domlaps/ultrasonic_radar/journey/README.md

# Build journey

How the radar went from a parts list to a working build, in order — including the mistakes.
The finished design (firmware, schematic, calculations) is in [`final/`](../final/).

| File | What's in it |
|---|---|
| [engineering-log.md](engineering-log.md) | Day-by-day record: decisions, measurements, what went wrong |
| [problems-and-fixes.md](problems-and-fixes.md) | Every fault I hit: what I saw → cause → how I found it → fix |
| [photos](photos/) | Photos in build order |

## Timeline in photos

### 1. First wiring attempt
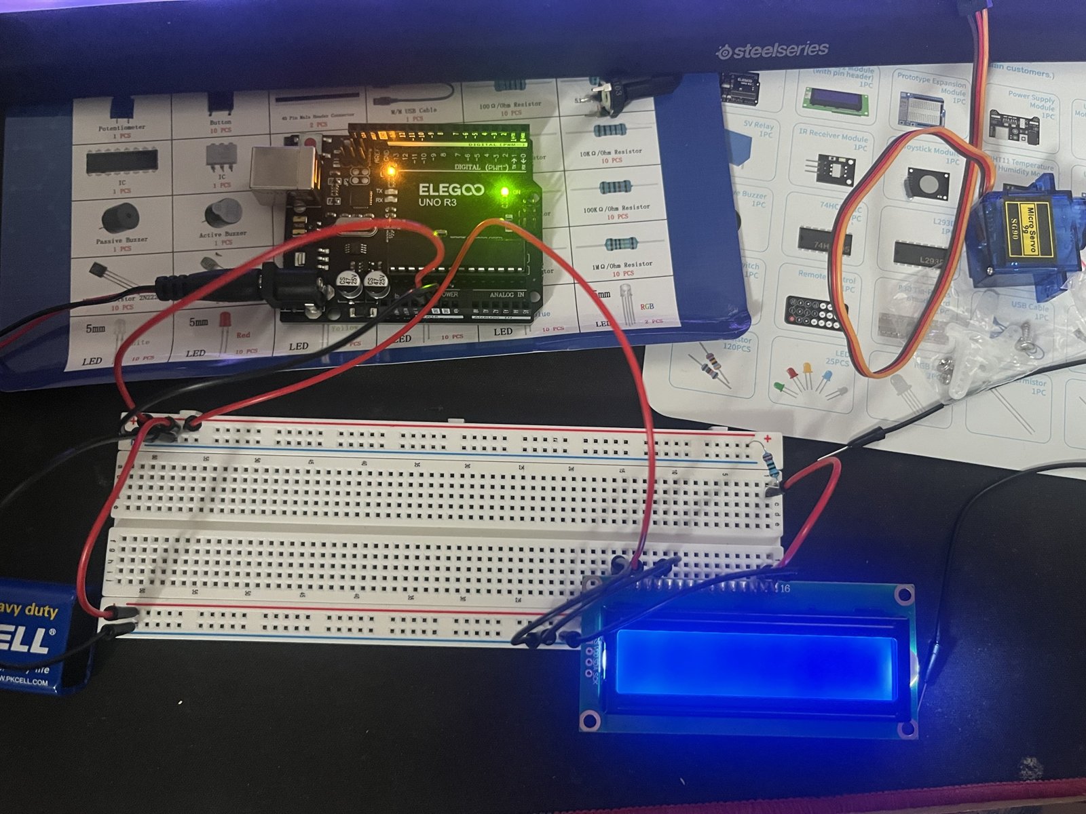
[picture p3: journey/photos/2026-10-24_01-first-wiring-attempt.jpg]
First wiring attempt


Getting the Uno, breadboard and LCD laid out for the first time, with the backlight powered.

### 2. Power rails and LCD backlight 
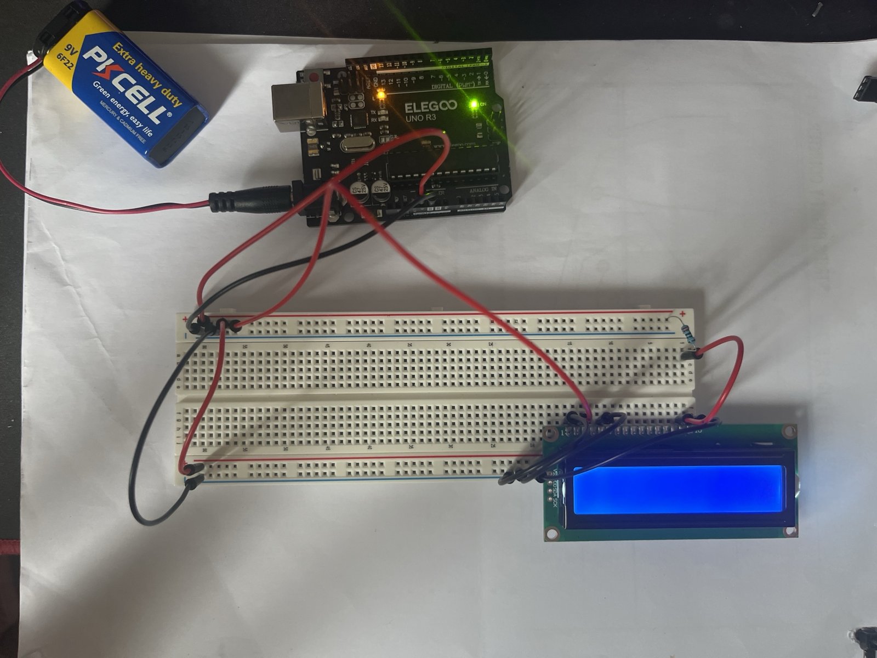
[picture p4: journey/photos/2026-10-24_02-power-rails-and-lcd-backlight.jpg]
Power rails and LCD backlight


9 V battery into the Uno's barrel jack; the breadboard rails are fed from the Uno's 5V and
GND pins, so the LCD only ever sees 5 V. Before this, one + rail on my first breadboard was
damaged and I swapped boards — see [problems-and-fixes.md](problems-and-fixes.md).

### 3. Contrast pot fitted
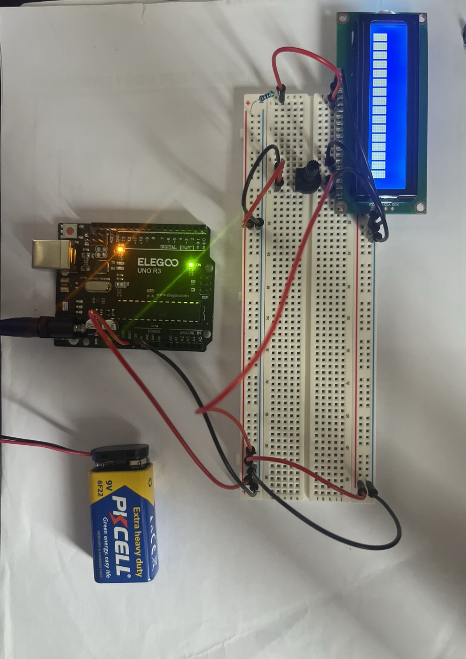
[picture p5: journey/photos/2026-10-24_03-contrast-pot-fitted.jpg]
Contrast pot fitted


With the 10 kΩ pot on V0 and no code running, the top line shows solid blocks: the LCD is
powered and the contrast works, but it hasn't been initialised yet.

### 4. Measuring the contrast voltage 
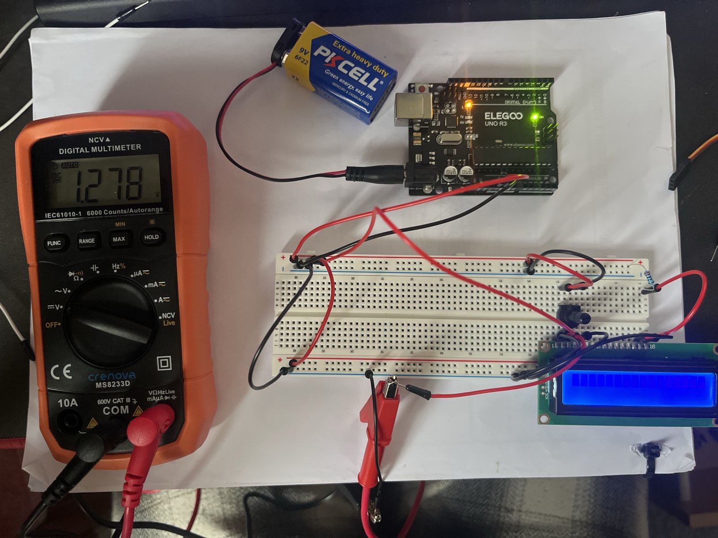
[picture p6: journey/photos/2026-10-24_04-lcd-v0-measurement.jpg]
Measuring V0


V0 = **1.278 V**, against the datasheet's ≈ 1.2 V (VDD − V0 = 3.8 V). That's about 2 % from
the recommended setting.

### 5. LCD wiring test passed 
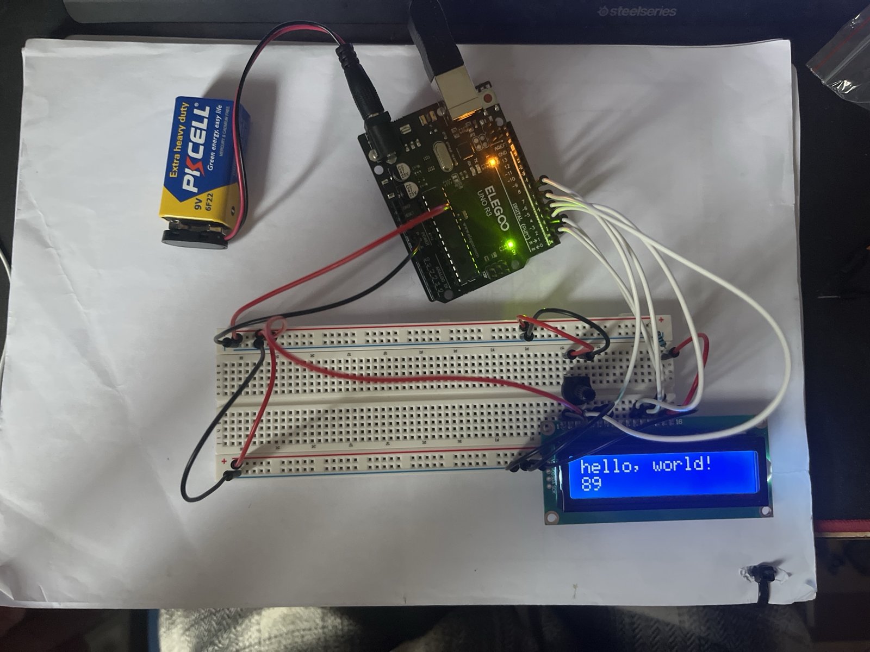
[picture p7: journey/photos/2026-10-24_05-lcd-helloworld-test.jpg]
LCD HelloWorld test


Six signal wires to the Uno and the IDE's HelloWorld example uploaded: text on line 1, a
seconds counter on line 2. The blocks from step 3 disappear once `lcd.begin()` runs.

### 6. LEDs and buzzer wired
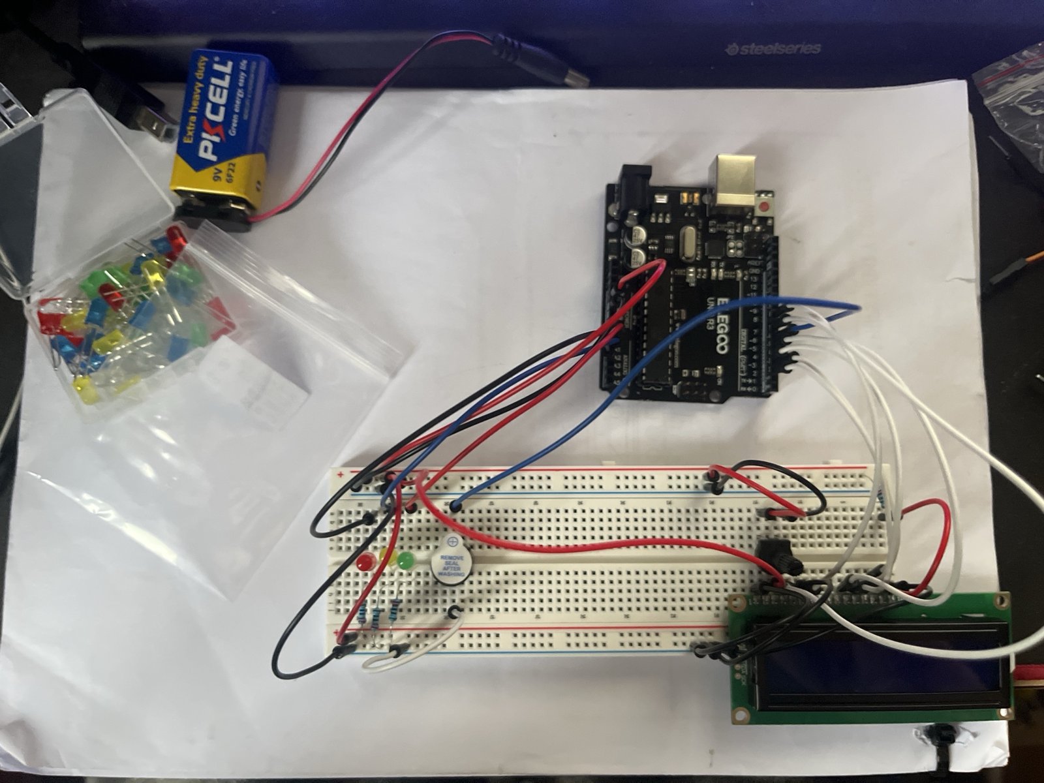
[picture p8: journey/photos/2026-10-24_06-leds-and-buzzer-wired.jpg]
LEDs and buzzer wired


Red, yellow and green LEDs, each with a 220 Ω resistor, plus the active buzzer, added to the
breadboard and wired to the Uno. Taken before powering up (the LCD is dark because the board
is unplugged), so this stage isn't tested yet.

### 7. Full circuit wired
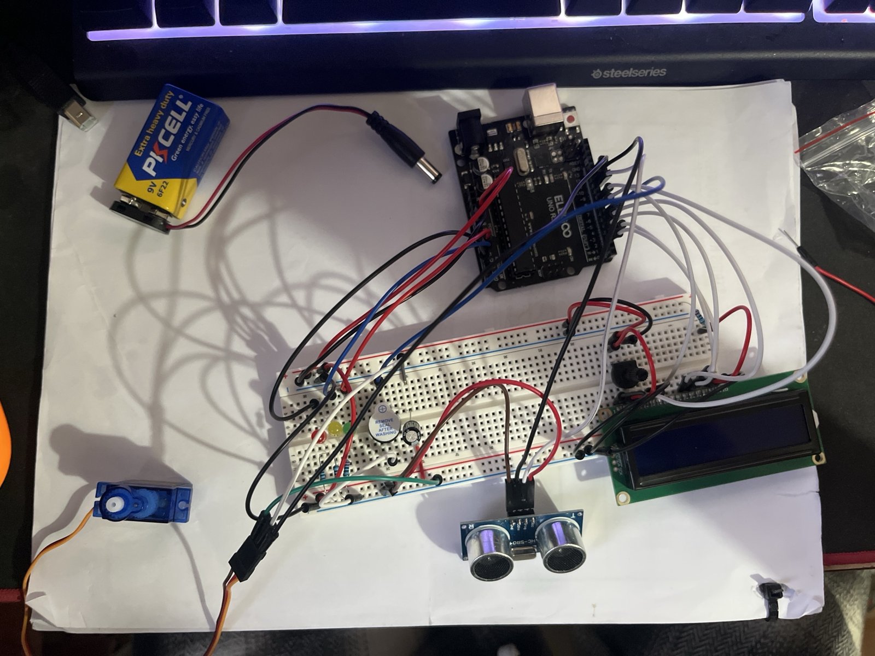
[picture p9: journey/photos/2026-10-24_07-full-circuit-wired.jpg]
Full circuit wired


Every part is now on the board: the HC-SR04 sensor and SG90 servo on jumper leads, and the
100 µF capacitor for the servo supply, alongside the LCD, LEDs and buzzer. Taken unpowered,
before the first full test. The sensor isn't mounted on the servo horn yet.

### 8. Working radar 
The finished build

First full run worked. The sensor is taped to the servo horn, and the LCD reads
"Angle: 90°, Dist: 20 cm" — right on the yellow/red boundary, with the yellow LED lit.

The radar reacting to my hand
