domlaps/ultrasonic_radar/final/hardware/images/schematic.png

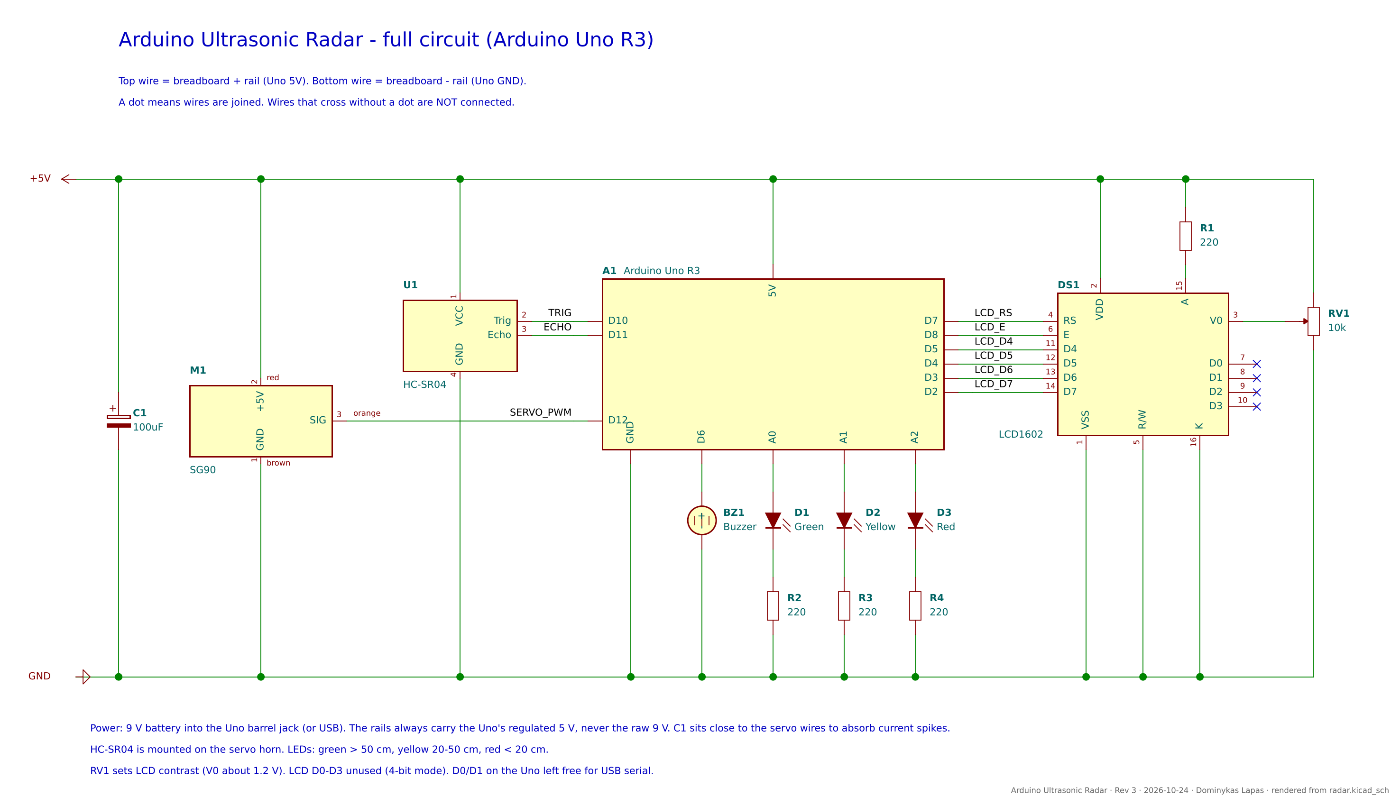
final/hardware/images/schematic.png
