domlaps/ultrasonic_radar/final/hardware/kicad/radar.kicad_sch

## KiCad design final/hardware/kicad/radar.kicad_sch (2026-10-24)

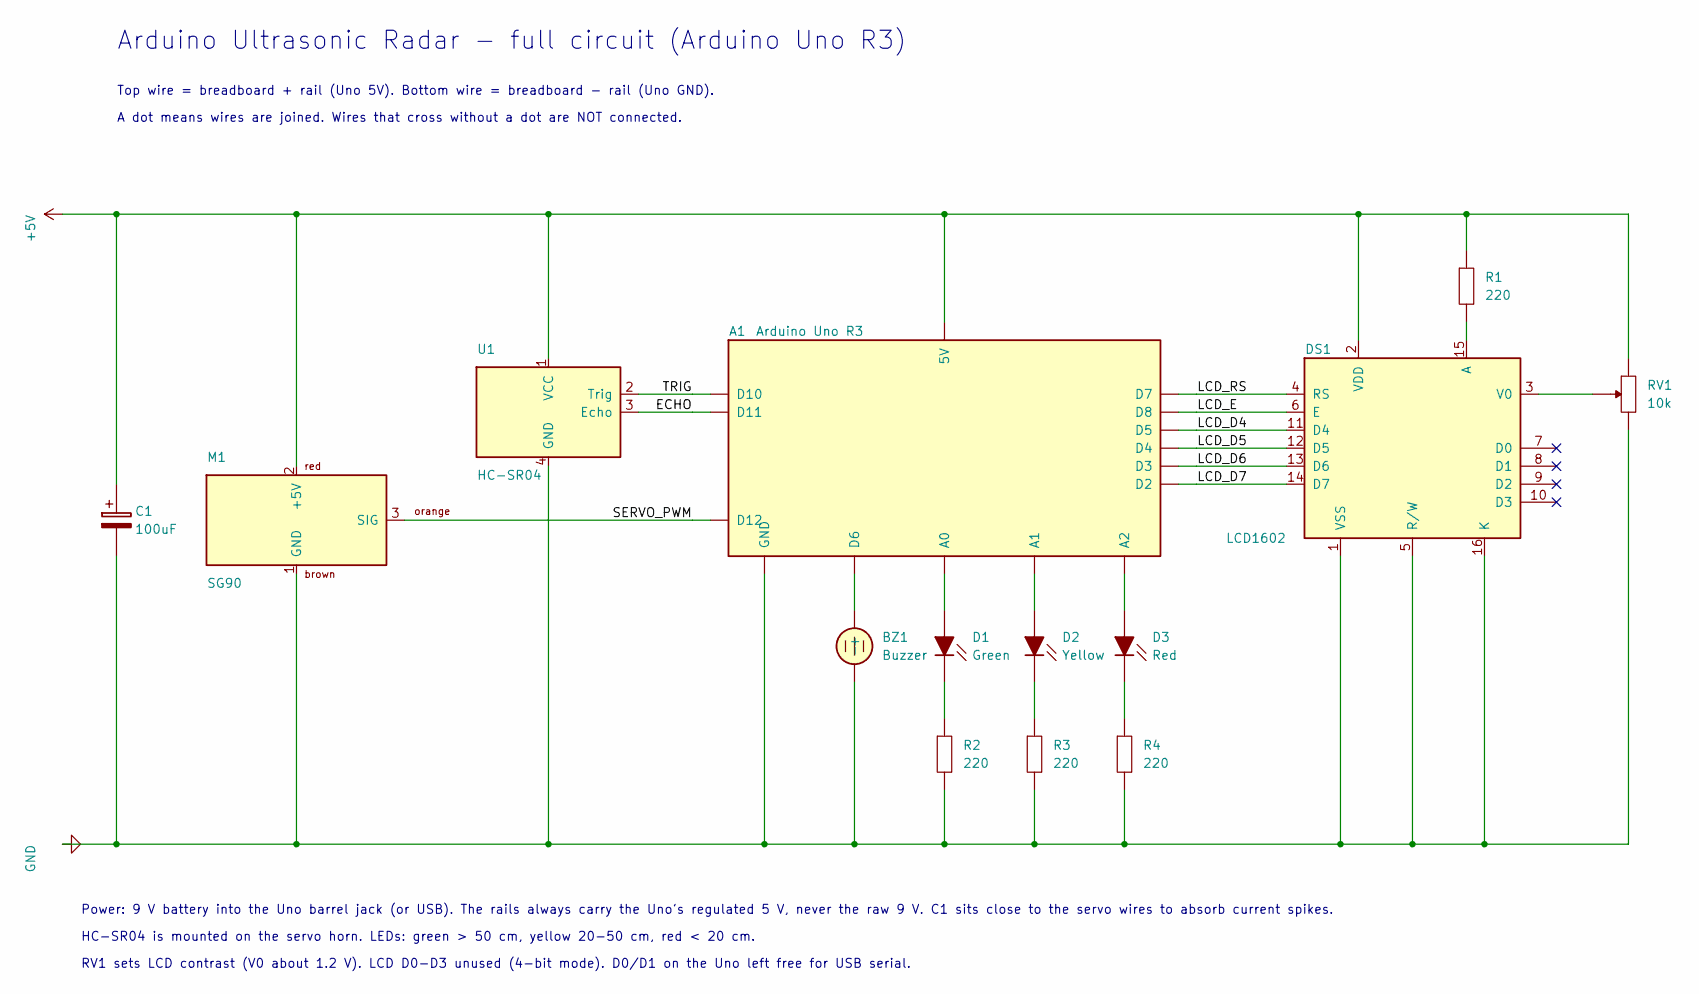
[picture p12: schematic radar.kicad_sch]

Parts:
A1: Arduino Uno R3
BZ1: Buzzer
C1: 100uF
D1: Green
D2: Yellow
D3: Red
DS1: LCD1602
M1: SG90
R1, R2, R3, R4: 220
RV1: 10k
U1: HC-SR04

Connections:
+5V: A1.5V, C1.1 (+), DS1.2 (VDD), M1.2 (+5V), R1.1, RV1.1, U1.1 (VCC)
ECHO: A1.D11, U1.3 (Echo)
GND: A1.GND, BZ1.2 (-), C1.2 (-), DS1.1 (VSS), DS1.5 (R/W), DS1.16 (K), M1.1 (GND), R2.2, R3.2, R4.2, RV1.3, U1.4 (GND)
LCD_D4: A1.D5, DS1.11 (D4)
LCD_D5: A1.D4, DS1.12 (D5)
LCD_D6: A1.D3, DS1.13 (D6)
LCD_D7: A1.D2, DS1.14 (D7)
LCD_E: A1.D8, DS1.6 (E)
LCD_RS: A1.D7, DS1.4 (RS)
unnamed: A1.A0, D1.2 (A)
unnamed: A1.A1, D2.2 (A)
unnamed: A1.A2, D3.2 (A)
unnamed: A1.D6, BZ1.1 (+)
unnamed: D1.1 (K), R2.1
unnamed: D2.1 (K), R3.1
unnamed: D3.1 (K), R4.1
unnamed: DS1.3 (V0), RV1.2 (W)
unnamed: DS1.15 (A), R1.2
SERVO_PWM: A1.D12, M1.3 (SIG)
TRIG: A1.D10, U1.2 (Trig)

Notes on the sheet:
Arduino Ultrasonic Radar - full circuit (Arduino Uno R3)
Top wire = breadboard + rail (Uno 5V). Bottom wire = breadboard - rail (Uno GND).
A dot means wires are joined. Wires that cross without a dot are NOT connected.
Power: 9 V battery into the Uno barrel jack (or USB). The rails always carry the Uno's regulated 5 V, never the raw 9 V. C1 sits close to the servo wires to absorb current spikes.
HC-SR04 is mounted on the servo horn. LEDs: green > 50 cm, yellow 20-50 cm, red < 20 cm.
RV1 sets LCD contrast (V0 about 1.2 V). LCD D0-D3 unused (4-bit mode). D0/D1 on the Uno left free for USB serial.
